virtualvisionlabs/bivouac-pat/dossier-29B/01-Impression-plastique.pdf

BIVOUAC / DOSSIER TECHNIQUE | RÉV. 29B · 08 OCT. 2026

# Maquette ergonomique en plastique

Spécification destinée au prestataire d’impression 3D • Échelle réelle 1:1

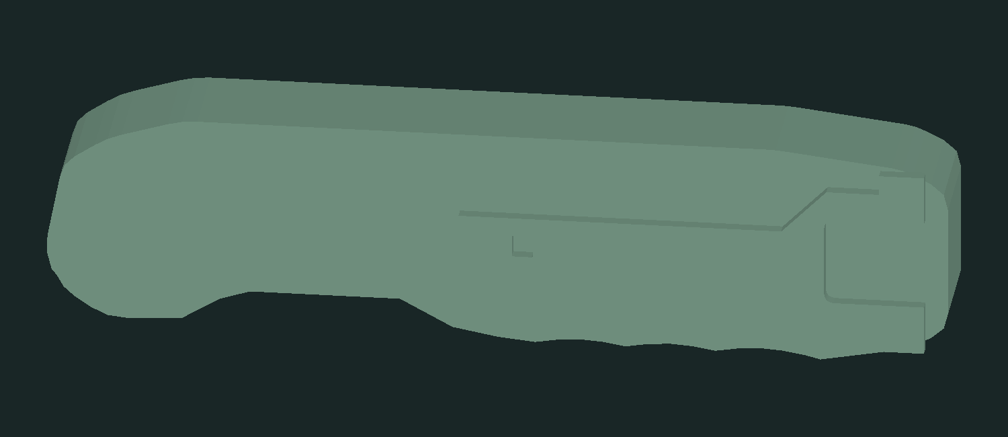
[picture p2: figure]

Aperçu du fichier imprimable : manche plein et volume de clip fixe. Monochrome.

## Objectifs de la maquette

Évaluer la longueur, l’épaisseur, les arrondis et les trois rainures du manche lors de la prise en main. Comparer le confort avec et sans le volume de la clip.

À commander | Dimensions nominales | Quantité proposée
01-Manche-plein-SANS-clip.stl | 120 × 30 × 14,4 mm | 1
02-Manche-plein-CLIP-FIXE.stl | 120 × 30 × 16,1 mm | 1

Deux variantes monoblocs indépendantes. Ces maquettes ne sont pas destinées à être assemblées entre elles. Le lot ne comprend ni lame, ni mécanisme, ni quincaillerie.

Priorité en cas de réalisation d’une seule variante : modèle CLIP-FIXE, destiné à évaluer l’encombrement complet dans la main.

BIV-29B-IMP · 29B · Assistance IA · Document non signé par un ingénieur | 1

# Instructions pour l’imprimeur

À joindre aux deux fichiers STL du dossier 01-Impression-plastique

Paramètre | Demande / point à confirmer
Unité et échelle | Importer en millimètres. Échelle 100 %. Ne pas ajuster à la taille du plateau.
Orientation | Grande face plane à Z=0 sur le plateau; clip vers le haut. Les fichiers sont déjà orientés ainsi.
Procédé proposé | FDM en PLA pour un essai de forme; PETG possible selon l’atelier. SLS PA12 possible, mais non nécessaire pour ce premier essai. [S6–S8]
Réglages de départ | Buse 0,4 mm, couche 0,20 mm, 3 périmètres, 5 couches haut/bas, remplissage 20 %. Proposition à adapter au profil machine.
Supports | Aucun support intérieur : les modèles sont pleins. Vérifier les surplombs dans le trancheur avant impression.
Finition | Ébavurer légèrement. Conserver les rainures et le contour. Ne pas poncer fortement les zones de prise avant la première évaluation.
Contrôle demandé | Mesurer longueur, largeur et épaisseur. Cible de réception proposée : ±0,3 mm sur les trois dimensions globales; à accepter par l’atelier.
Masse | La masse imprimée dépend du remplissage. Elle ne reproduit pas le poids ou l’équilibre du couteau métallique.

Le plastique imprimé sert seulement à la prise en main. Il n’est pas proposé ici pour manger, couper, gratter une pierre à feu ou tester la résistance d’une clip.

BIV-29B-IMP · 29B · Assistance IA · Document non signé par un ingénieur | 2

# Périmètre de la maquette

Caractéristiques reproduites et limites de représentativité

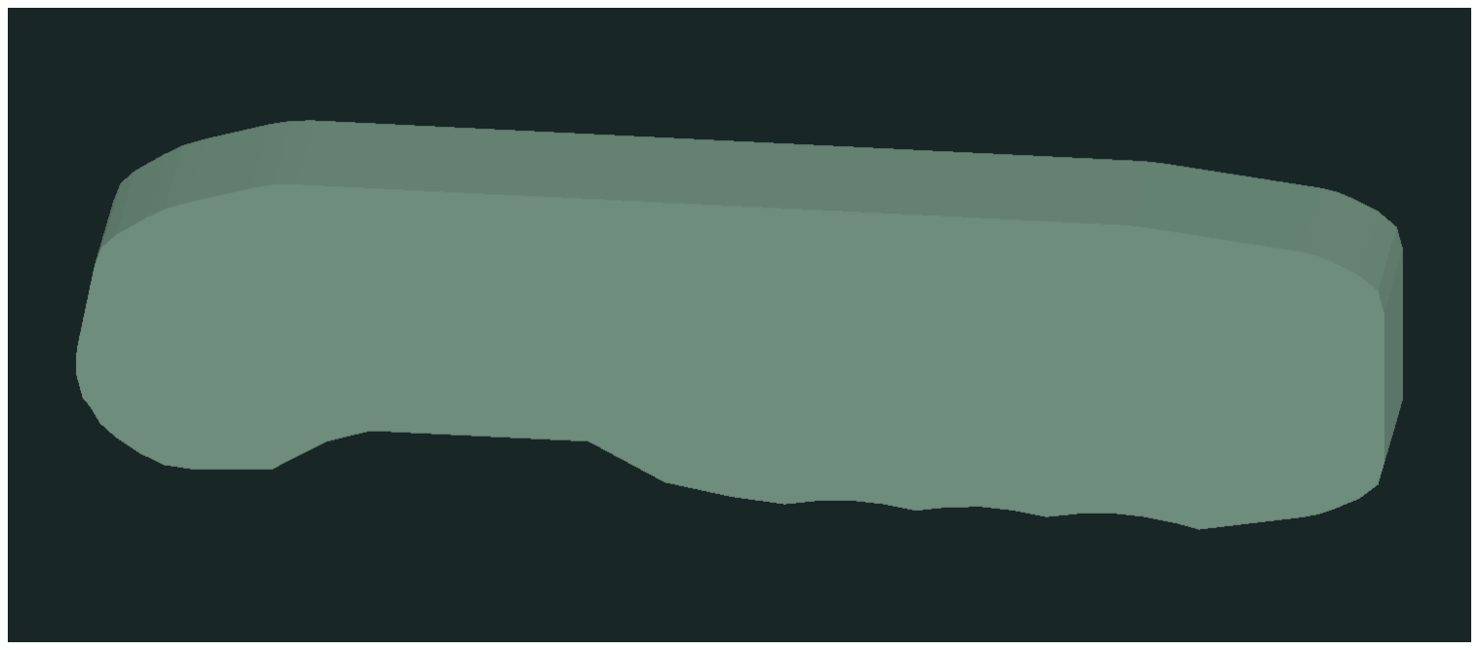
[picture p3: figure]

Reproduit | Simplifié / absent
Contour du manche v29, arrondis en vue de face, trois rainures basses. | Intérieur rempli : pas de canaux, ressorts, fourchette mobile ou allume-feu.
Longueur 120 mm; largeur maximale 30 mm; corps 14,4 mm. | Pas de texture G10 ni de finitions métalliques; aucune lame, même factice.
Empreinte et encombrement supérieur de la clip dans la deuxième version. | Clip solidaire du manche, vide sous la clip rempli, dessus ramené à une enveloppe plane. Pas de flexion ni d’essai de port en poche.
Épaisseur totale 16,1 mm avec le volume fixe de clip. | Gravures et détails de vis supprimés. L’adhérence du pouce et l’accès aux accessoires ne sont pas validés par cette maquette.

L’étui n’est pas inclus dans ce premier lot imprimable. Le dossier fabricant et les GLB le décrivent séparément. Un essai d’emboîtement avec pièces mobiles demandera une seconde maquette, avec jeux adaptés au procédé choisi.

BIV-29B-IMP · 29B · Assistance IA · Document non signé par un ingénieur | 3

# Fiche d’évaluation ergonomique

À remplir après réception • Aucun outil ni mise en charge nécessaire

Observation | Résultat / modification souhaitée
Date, matière et atelier | ____________________________________________
Dimensions mesurées L × l × e | ____________________________________________
Main dominante / gants | ____________________________________________
Longueur du manche | Trop court / correct / trop long
Épaisseur | Trop mince / correcte / trop épaisse
Rainures sous les doigts | Gênantes / neutres / utiles
Angle sous l’index et talon | ____________________________________________
Volume de clip dans la paume | Gênant / acceptable / confortable
Tenue pendant 30 à 60 secondes | Points de pression : __________________________
Version préférée et raison | ____________________________________________
Décision pour la suite | Garder les formes / corriger avant la maquette mobile

Noter les retouches souhaitées en millimètres si possible et photographier la main autour de la maquette. Évaluer d’abord la forme; ne pas conclure sur le poids, la retenue ou la solidité du futur couteau.

BIV-29B-IMP · 29B · Assistance IA · Document non signé par un ingénieur | 4

# Vérification des fichiers et commande

Fichiers maillés contrôlés numériquement • Impression physique non réalisée

Fichier | Résultat du contrôle
01-Manche-plein-SANS-clip.stl | 1 volume connecté fermé; normales cohérentes; 216 triangles; dimensions relues après export conformes à 0,002 mm près.
02-Manche-plein-CLIP-FIXE.stl | 1 volume connecté fermé; normales cohérentes; 792 triangles; dimensions relues après export conformes à 0,002 mm près.

## Objet de la consultation

Réalisation de deux maquettes ergonomiques de manche, à raison d’un exemplaire par variante, à l’échelle 100 % en millimètres. Matière proposée : PLA, finition simple. Le prestataire est invité à vérifier les fichiers dans son trancheur et à confirmer l’orientation, le coût et les dimensions obtenues. Aucune pièce métallique ni aucun mécanisme ne fait partie de ce lot.

## Références matière

S6 — Formlabs — Nylon 12 SLS, guide matière. Consulter le fabricant. (https://now.formlabs.com/resources/nylon-12-sls)

S7 — Prusa — guide des filaments. Consulter le fabricant. (https://help.prusa3d.com/filament-material-guide)

S8 — Prusa — PETG. Consulter le fabricant. (https://help.prusa3d.com/article/petg_2059)

Références consultées le 8 octobre 2026. Les réglages proposés sont un point de départ pour l’atelier, pas une qualification d’imprimante.

BIV-29B-IMP · 29B · Assistance IA · Document non signé par un ingénieur | 5
