virtualvisionlabs/bivouac-pat/dossier-29B/03-Patrons-echelle-1.pdf

# Manche fermé — patron à l’échelle 1:1

Imprimer à 100 % / taille réelle. Désactiver « Ajuster à la page ». Toutes les dimensions sont en mm.

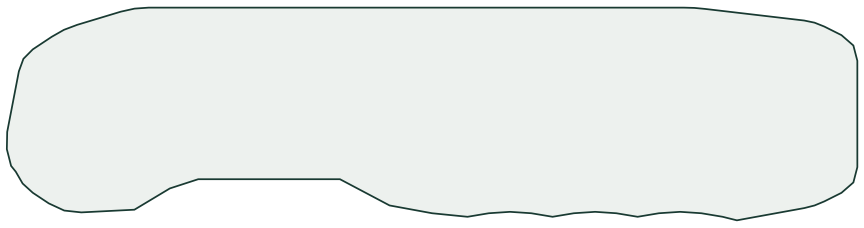
[picture p4: figure]

BIV-29B-GAB · 08/10/2026 · Contours de référence, pas des tracés de découpe de production · 1/2

### Contour 120 × 30 mm — corps de 14,4 mm hors clip

Épaisseur du manche sans clip : 14,4 mm (rectangle de contrôle).

Enveloppe avec clip : 16,1 mm. Ce rectangle ne représente pas sa cambrure.

Cette barre doit mesurer exactement 100 mm sur le papier.

# Étui et lame — contours de référence 1:1

Imprimer à 100 % / taille réelle. Désactiver « Ajuster à la page ». Toutes les dimensions sont en mm.

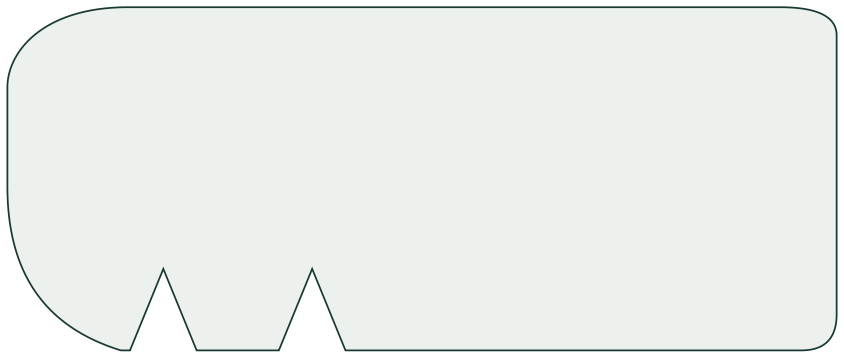
[picture p5: figure]

BIV-29B-GAB · 08/10/2026 · Contours de référence, pas des tracés de découpe de production · 2/2

Étui : profil 117 × 48,4 mm; épaisseur totale 24,75 mm avec clip.

Lame : contour total 100 × 22,893 mm, talon inclus. Pas de biseau ni de tolérance de fabrication.

Cette barre doit mesurer exactement 100 mm sur le papier.
