virtualvisionlabs/bivouac-pat/apercu.jpg

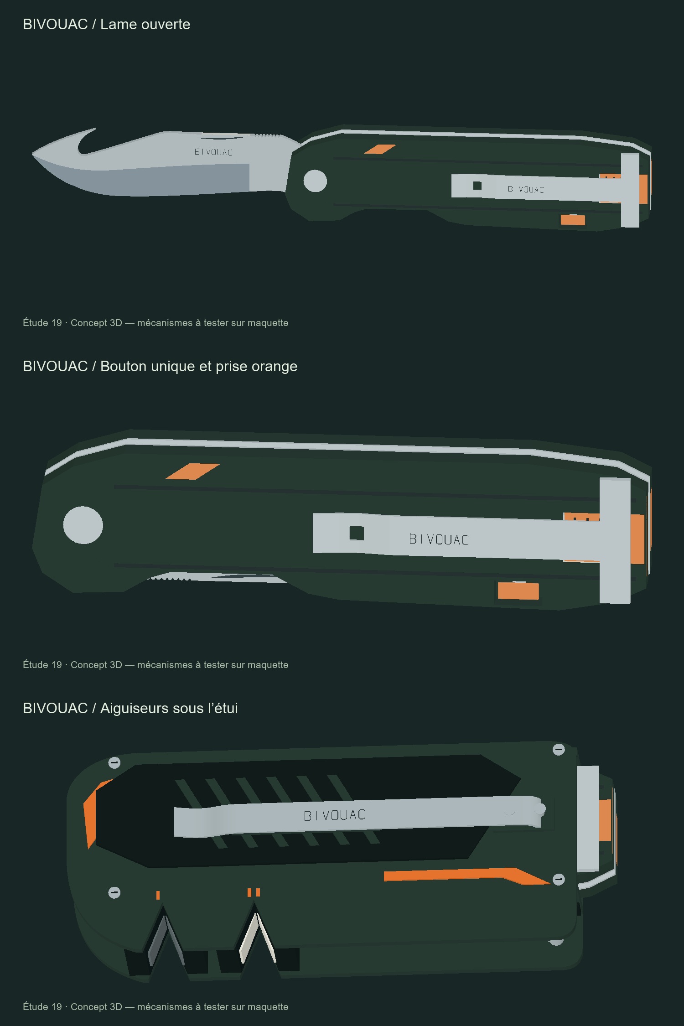
apercu.jpg
