virtualvisionlabs/bivouac-pat/BIVOUAC-verrou-explique.png

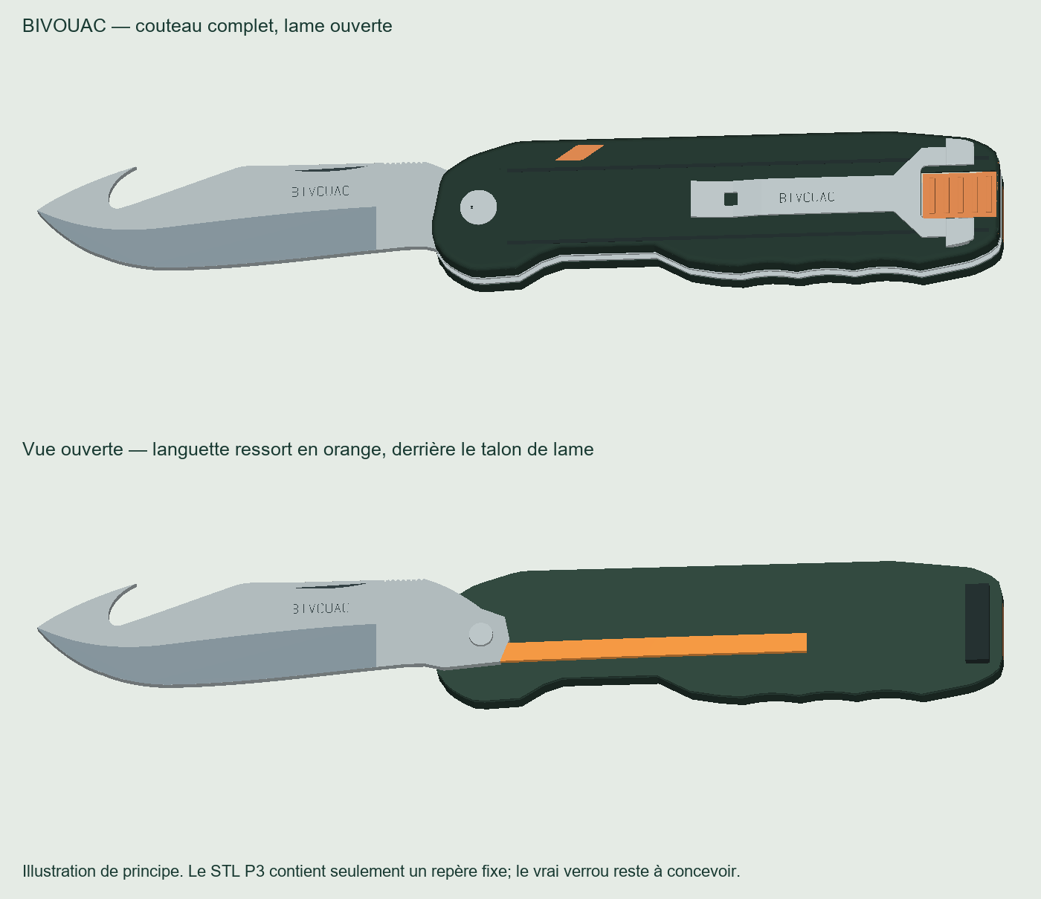
BIVOUAC-verrou-explique.png
