virtualvisionlabs/bivouac-pat/dossier-29B/couteau.png

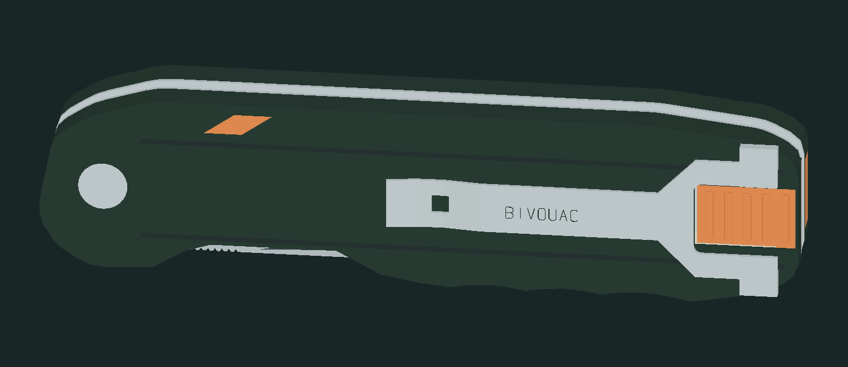
dossier-29B/couteau.png
