virtualvisionlabs/bivouac-pat/etui-e1/Apercu-etui-E1.png

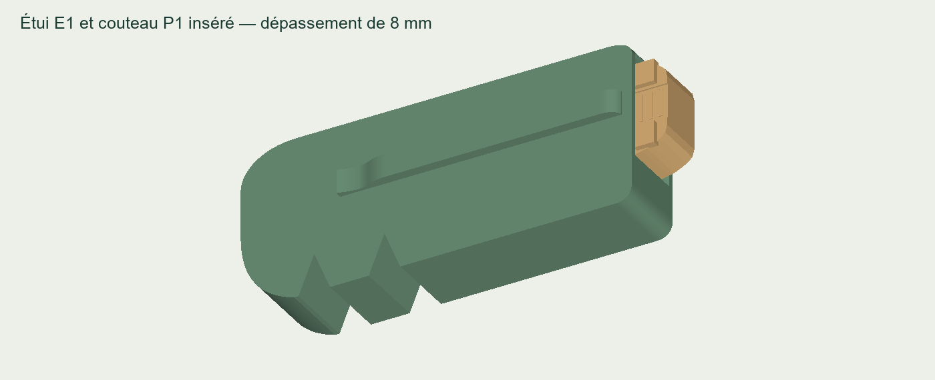
etui-e1/Apercu-etui-E1.png
