virtualvisionlabs/bivouac-pat/etui-e1/Coupe-explicative-E1.png

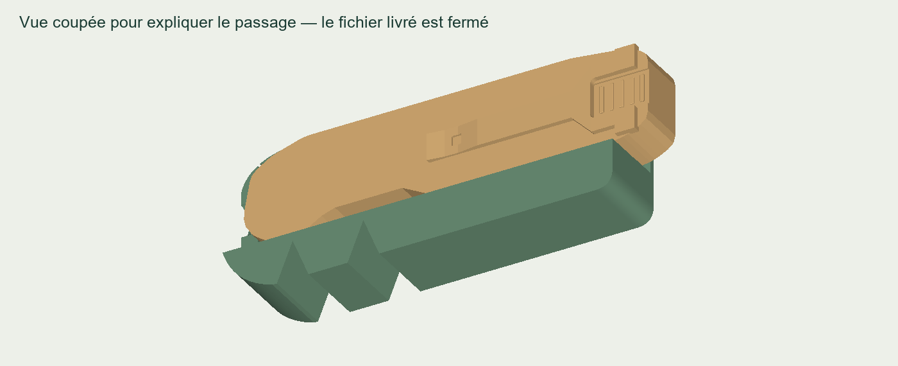
etui-e1/Coupe-explicative-E1.png
