virtualvisionlabs/bivouac-pat/film-affiche.jpg

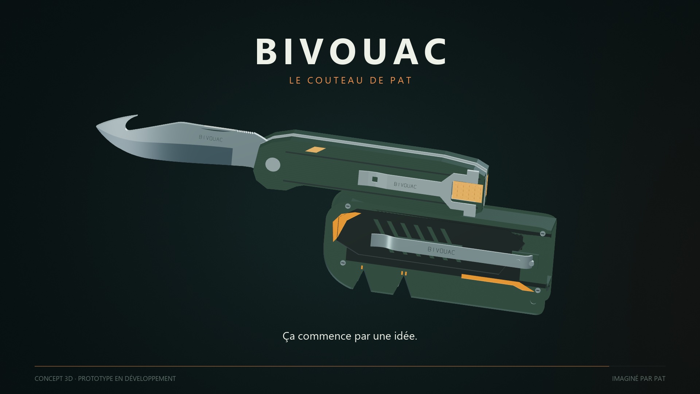
film-affiche.jpg
