virtualvisionlabs/bivouac-pat/maquette-p1/Apercu-maquette-P1.png

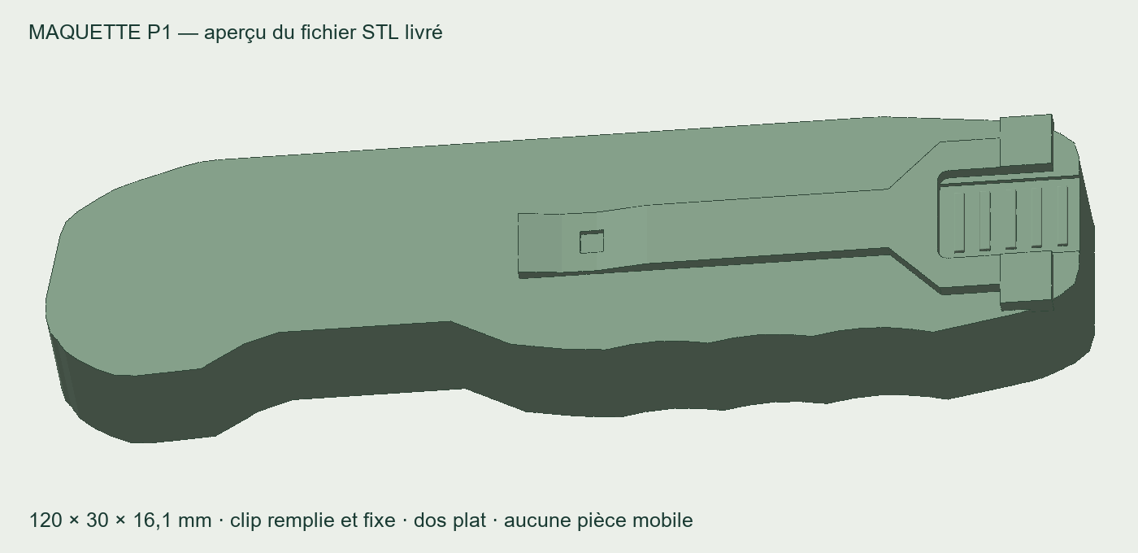
maquette-p1/Apercu-maquette-P1.png
