virtualvisionlabs/bivouac-pat/maquette-p2/Apercu-maquette-P2.png

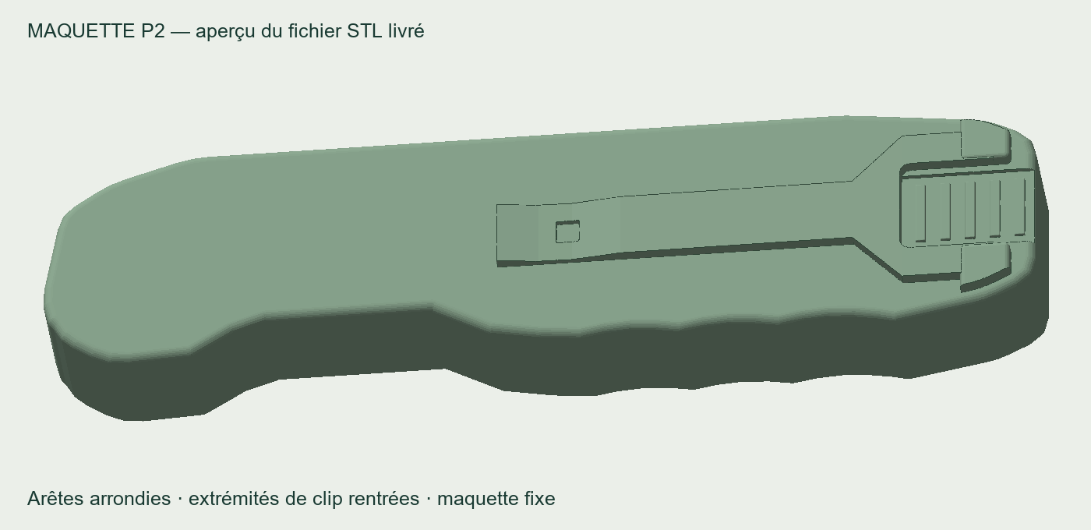
maquette-p2/Apercu-maquette-P2.png
