virtualvisionlabs/bivouac-pat/p3-e2/Couteau-P3.png

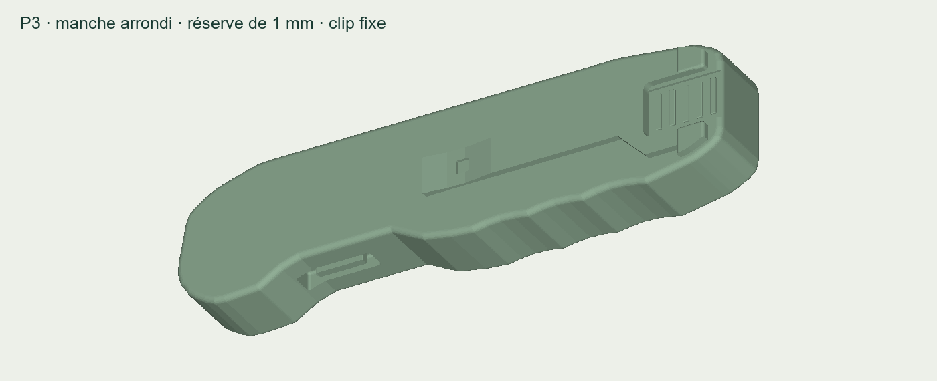
p3-e2/Couteau-P3.png
