virtualvisionlabs/bivouac-pat/p3-e2/Dos-P3.png

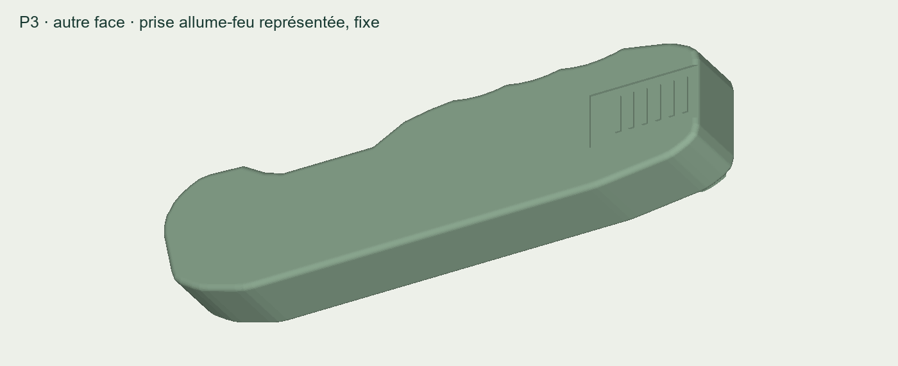
p3-e2/Dos-P3.png
