virtualvisionlabs/bivouac-pat/etui-e1/02-Gabarit-ajustement-OPTIONNEL-mm.3mf

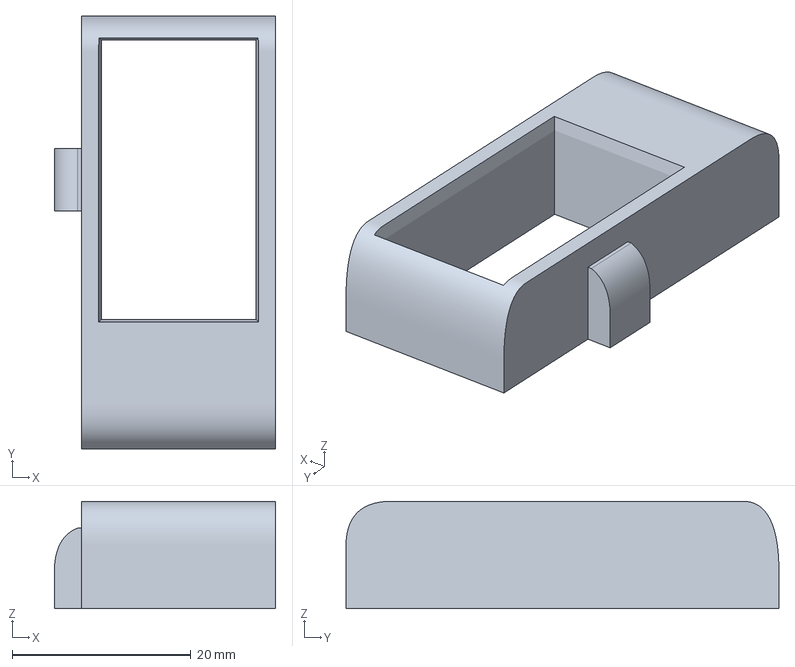
[picture p16: CAD file, 2026-10-10]
etui-e1/02-Gabarit-ajustement-OPTIONNEL-mm.3mf
24.8 x 48.4 x 12.0 mm
