virtualvisionlabs/bivouac-pat/maquette-p1/BIVOUAC-Maquette-fermee-P1-mm.3mf

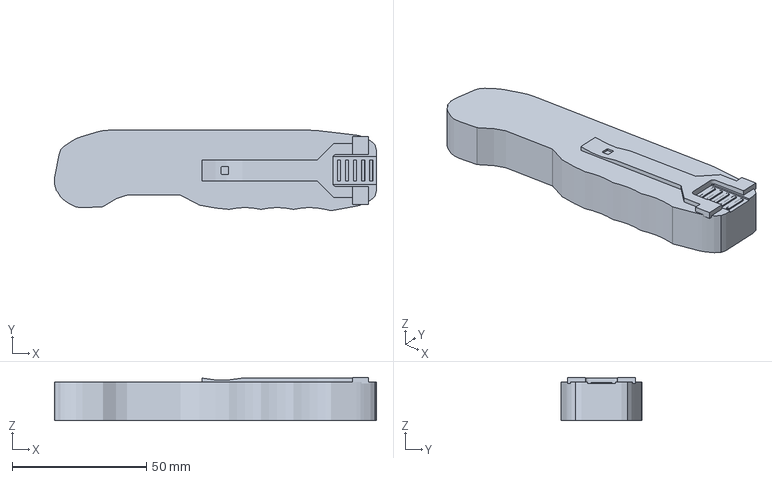
[picture p17: CAD file, 2026-10-09]
maquette-p1/BIVOUAC-Maquette-fermee-P1-mm.3mf
120.0 x 30.0 x 16.1 mm
