virtualvisionlabs/bivouac-pat/maquette-p2/BIVOUAC-Maquette-fermee-P2-mm.3mf

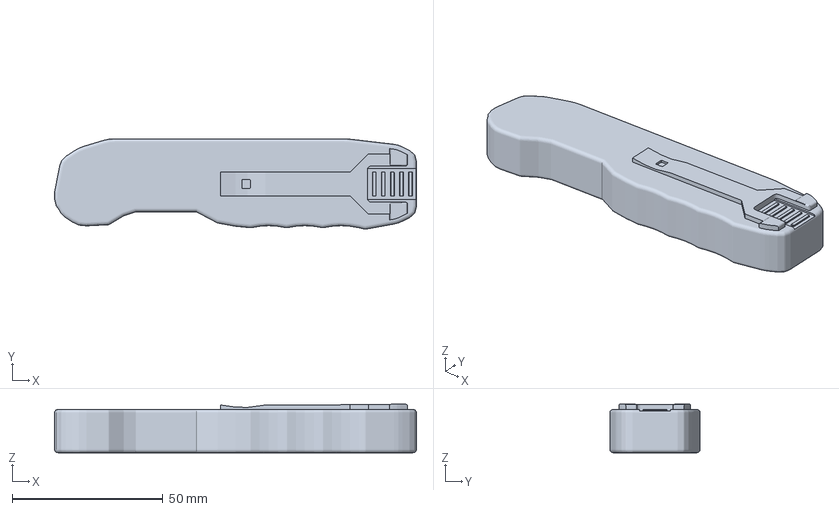
[picture p18: CAD file, 2026-10-11]
maquette-p2/BIVOUAC-Maquette-fermee-P2-mm.3mf
120.0 x 30.0 x 16.1 mm
