virtualvisionlabs/bivouac-pat/p3-e2/BIVOUAC-Maquette-fermee-P3-mm.3mf

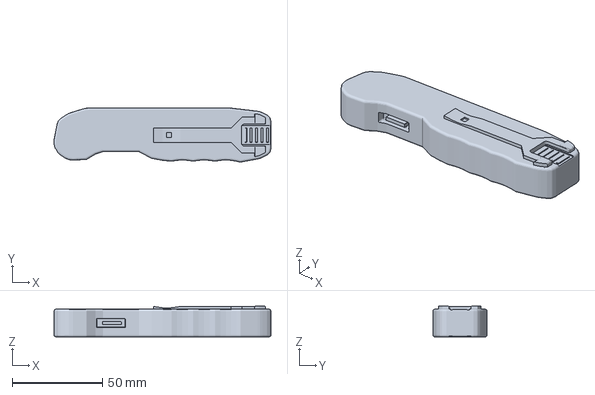
[picture p19: CAD file, 2026-10-11]
p3-e2/BIVOUAC-Maquette-fermee-P3-mm.3mf
120.0 x 30.0 x 17.1 mm
