virtualvisionlabs/bivouac-pat/etui-e1/01-Etui-E1-pour-couteau-P1-mm.3mf

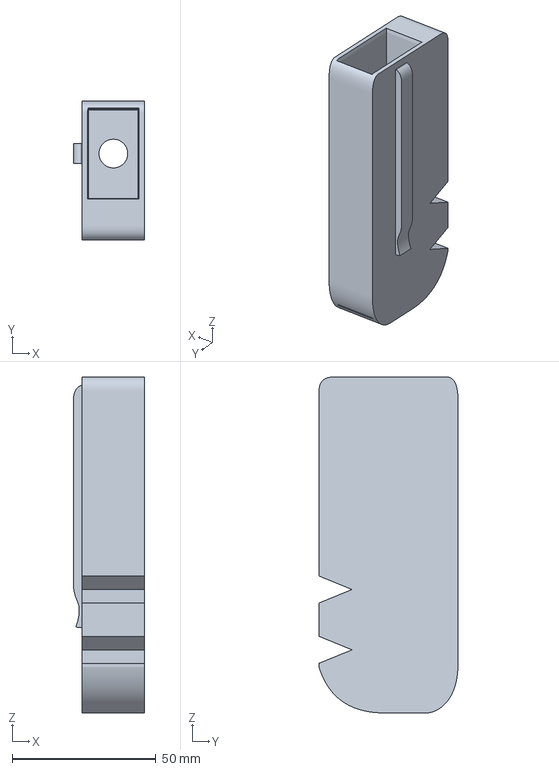
[picture p20: CAD file, 2026-10-10]
etui-e1/01-Etui-E1-pour-couteau-P1-mm.3mf
24.8 x 48.4 x 117.0 mm
