virtualvisionlabs/bivouac-pat/p3-e2/Gabarit-E2-OPTIONNEL-mm.3mf

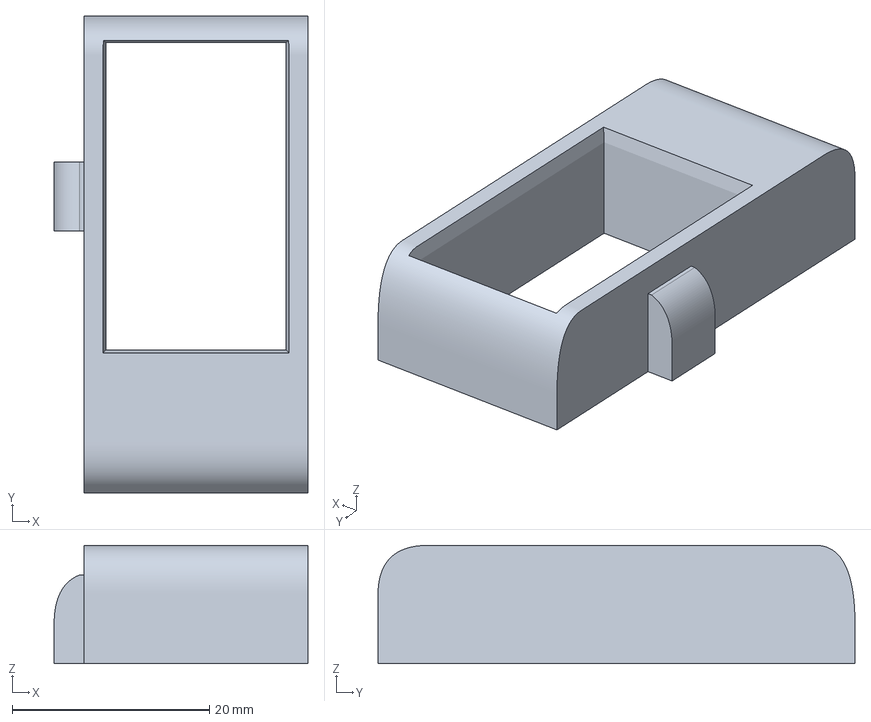
[picture p21: CAD file, 2026-10-11]
p3-e2/Gabarit-E2-OPTIONNEL-mm.3mf
25.8 x 48.4 x 12.0 mm
