virtualvisionlabs/bivouac-pat/prototype-plastique/02-Etui-complet-E2-pour-P3-mm.stl

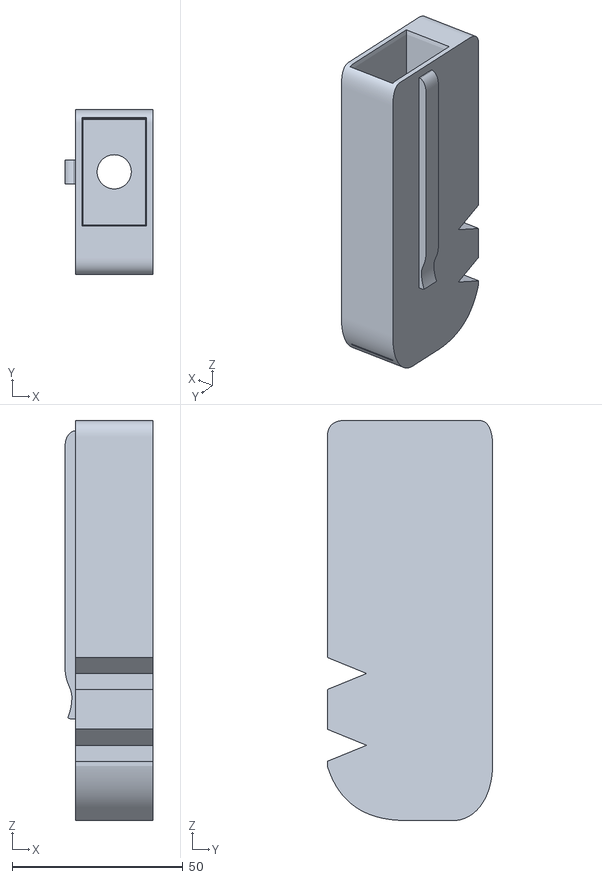
[picture p22: CAD file, 2026-10-11]
prototype-plastique/02-Etui-complet-E2-pour-P3-mm.stl
25.8 x 48.4 x 117.0
