virtualvisionlabs/bivouac-pat/(list of files, cad)

Other CAD files:
prototype-plastique/01-Couteau-complet-P3-mm.stl
p3-e2/Etui-E2-pour-P3-mm.3mf
etui-e1/01-Etui-E1-pour-couteau-P1-mm.stl
etui-e1/02-Gabarit-ajustement-OPTIONNEL-mm.stl
maquette-p1/BIVOUAC-Maquette-fermee-P1-mm.stl
maquette-p2/BIVOUAC-Maquette-fermee-P2-mm.stl
p3-e2/Gabarit-E2-OPTIONNEL-mm.stl
