virtualvisionlabs/bivouac-pat/maquette-p2/Instructions-imprimeuse-P2.pdf

## BIVOUAC / MAQUETTE PLASTIQUE P2

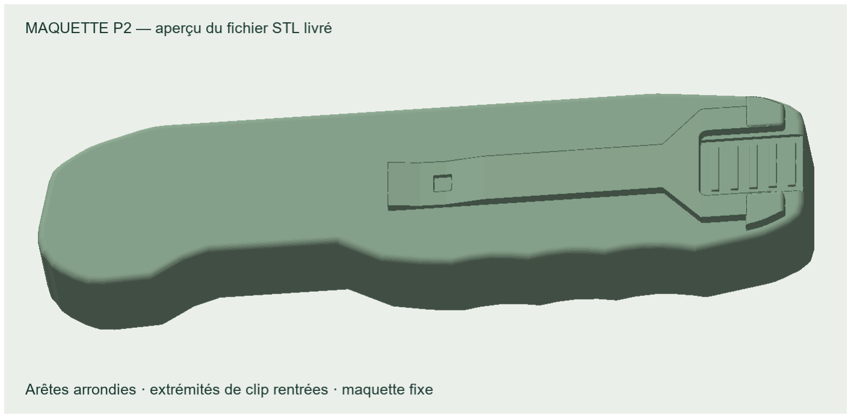
[picture p23: figure]

Objet : une maquette fermée inerte en PLA, d’un seul bloc, pour évaluer la prise en main. Révision P2 issue du retour sur l’impression P1. Aucun mécanisme mobile ni fonction coupante.

Modifications : arêtes périphériques du manche arrondies (rayon nominal 1,2 mm); deux extrémités de clip adoucies (rayon nominal 0,6 mm) et limitées à un contour situé 1,6 mm à l’intérieur du manche. Hauteur de clip conservée. Dos central plat; relief du côté allume-feu non ajouté dans cette révision.

Fichiers : BIVOUAC-Maquette-fermee-P2-mm.3mf ou .stl, deux formats du même objet. En choisir un seul. Unités : millimètres; échelle 100 %. Encombrement mesuré : 120,00 × 29,97 × 16,10 mm (valeurs arrondies).

Orientation et réglages proposés : dos plat sur le plateau, relief de clip vers le haut (orientation fournie). Buse 0,4 mm; couche 0,16 mm, première 0,20 mm; 4 périmètres; 6 couches pleines dessus/dessous; 30 % gyroid. Contrôler les supports et adapter températures/adhérence au profil de l’atelier.

Vérifications numériques : un solide fermé, 7,368 triangles, normales cohérentes, aucune face dégénérée. Import STL/3MF et tranchage réussis. Estimation générique : 28.48 g, supports compris, et 3h 2m 43s; l’atelier confirme avec sa machine.

Étui E1 : absence de collision vérifiée sur 455 positions d’insertion/retrait, dont des décalages de ±0,5 mm. Le jeu et le confort restent à vérifier sur les pièces imprimées. Ébavurer, mesurer et essayer la première pièce. Aucun essai physique P2 effectué; aucun G-code machine fourni.

P2 · 11 octobre 2026 · Maquette ergonomique uniquement · Pas de pièces à assembler
