virtualvisionlabs/bivouac-pat/etui-e1/Instructions-imprimeuse-E1.pdf

## ÉTUI E1 / IMPRESSION POUR MAQUETTE P1

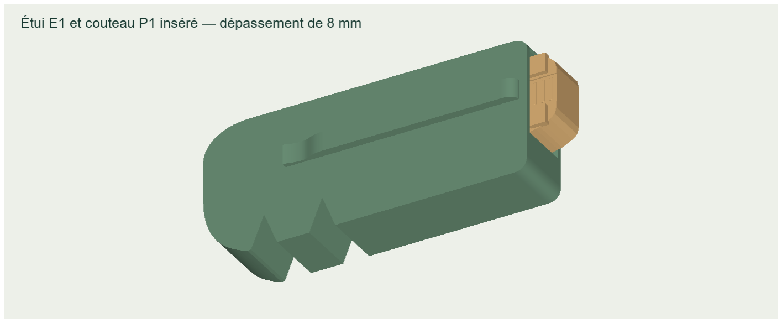
[picture p24: figure]

Prestation : imprimer un étui creux en PLA pour recevoir le couteau fermé P1 de 120 × 30 × 16,1 mm. Ce paquet ne contient pas le couteau. Sans verrou : il peut glisser hors de l’étui. Relief de clip fixe; affûteurs et tige non fonctionnels.

Dimensions : étui 117 × 48,4 × 24,75 mm; passage 31,2 × 17,3 mm, soit 0,6 mm de jeu nominal de chaque côté. Enfoncement 112 mm; talon accessible sur 8 mm. Trou avant Ø 10 mm. Fond et toit principaux de 2,2 mm; entrée légèrement évasée.

Fichier principal 01 : choisir le 3MF ou le STL, pas les deux. Millimètres, échelle 100 %. Il est orienté nez au plateau, ouverture vers le haut; hauteur d’impression 117 mm. Ce positionnement maintient le canal vertical.

Gabarit facultatif 02 : petite section traversante de 12 mm à tester avec le P1 déjà imprimé. Vérifier que le couteau, clip comprise, coulisse sans forcer. Essai conseillé avant l’étui complet. Si serré, revoir le jeu; ne pas agrandir tout l’étui automatiquement. Le gabarit contrôle le passage, pas les frottements sur toute la longueur.

Réglages proposés : PLA, buse 0,4 mm, couche 0,20 mm, 4 périmètres, 5 couches pleines haut/bas, gyroid 25 %. Bordure de 8 mm (4 mm pour le gabarit). Supports depuis le plateau sous les débords extérieurs. Garder le canal dégagé; inspecter toutes les couches avec le profil réel de l’atelier. Températures selon le filament.

Vérifications : chaque fichier est un solide fermé unique. Passage du P1 contrôlé sans intersection à 251 positions nominales et 204 positions décalées. Imports STL/3MF et tranchages réussis dans PrusaSlicer 2.9.2. Ajustement physique encore à confirmer sur les impressions réelles.

Estimations d’essai générique : étui ≈ 56 g / 5 h 01; gabarit ≈ 6 g / 33 min, bordures et supports compris. L’atelier confirme ses durées et son prix. Retirer les supports, ébavurer l’entrée et le passage avant essai. Aucun G-code machine fourni.

E1 · 9 octobre 2026 · Étui de maquette uniquement · Compatibilité numérique : couteau P1
