virtualvisionlabs/bivouac-pat/maquette-p1/Instructions-imprimeuse-P1.pdf

## BIVOUAC / MAQUETTE PLASTIQUE P1

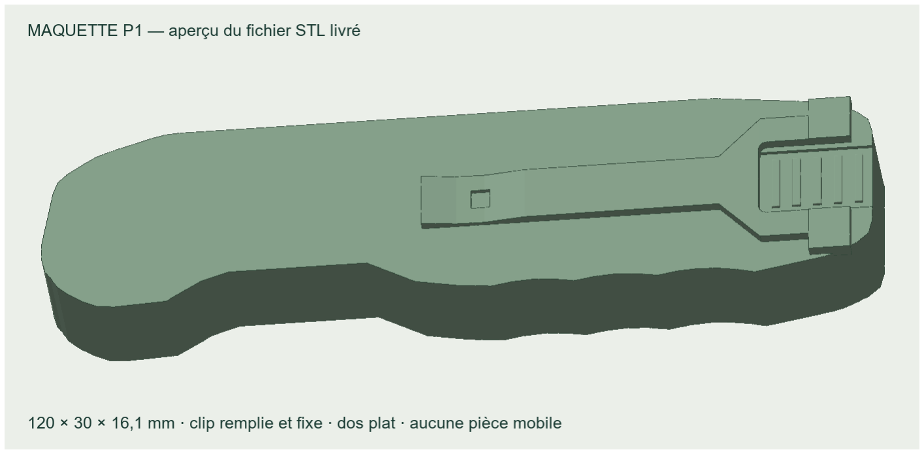
[picture p25: figure]

Objet de la prestation : imprimer une copie en PLA du couteau fermé, à taille réelle, pour évaluer forme, encombrement et prise en main. Maquette inerte d’un seul bloc; aucun mécanisme ni usage coupant.

Fichier : BIVOUAC-Maquette-fermee-P1-mm.3mf (unités incluses) ou .stl (importer en millimètres). Les deux formats représentent le même objet : en choisir un seul. Échelle 100 %. Dimensions : 120 × 30 × 16,1 mm.

Orientation : face arrière plane sur le plateau, relief de clip vers le haut. Le fichier est déjà orienté avec le dessous à Z = 0. La clip est remplie et fixe; le dos est aplani. Rainures de contour, galbe supérieur de clip, dépression de pouce et cinq nervures avant conservés. Textures, couleurs et microgravures de la démo ne sont pas reproduites.

Préparation proposée : buse 0,4 mm; couches 0,16 mm (première 0,20); 4 périmètres; 6 couches pleines en haut et en bas; remplissage gyroid 30 %. Activer et contrôler les supports, notamment sous les extrémités latérales de la clip. Températures et adhérence selon le PLA et le profil éprouvé de l’atelier.

Contrôles effectués : un seul solide fermé, normales cohérentes, 3 454 triangles. Import et tranchage réussis dans PrusaSlicer 2.9.2. Essai générique : environ 29 g de filament, supports compris, et environ 3 h 07. Ce ne sont pas un devis ni une garantie pour une autre machine.

À réaliser par l’atelier : utiliser le profil de son imprimante, vérifier les supports et l’aperçu des couches, retirer les supports, ébavurer puis contrôler les dimensions. Aucune réparation d’enveloppes multiples n’est demandée. Aucun essai physique réalisé à ce jour. Le G-code d’essai n’est pas livré; il ne correspond pas à la machine de l’atelier.

P1 · 9 octobre 2026 · Maquette ergonomique uniquement · Pas de pièces à assembler
