virtualvisionlabs/bivouac-pat/verification-stl-v28/Verification-STL-complet-v28.pdf

BIVOUAC / CONTRÔLE DE MAQUETTE | V28 · RAPPORT A

# Résultat de la vérification

Dimensions cohérentes. Préparation du maillage à terminer avant impression. Le fichier reçu ne peut pas être confirmé comme un unique solide fusionné prêt à imprimer. Cette réserve concerne la préparation du STL, pas le choix esthétique du produit.

Objet examiné : couteau fermé v28, maquette inerte destinée à la prise en main. Aucune pièce mobile, aucune utilisation coupante. Le fichier reçu est conservé sans modification; aucun nouveau STL n’est produit, conformément à la demande jointe.

Contrôle | Constat
Dimensions du STL | 120,029 × 30,140 × 16,100 mm
GLB v28 de référence | 120,000 × 30,000 × 16,100 mm
Écart d’enveloppe | +0,029 mm en longueur; +0,140 mm en hauteur; épaisseur identique à l’arrondi.
Triangles / coordonnées | 232 112 triangles; aucune coordonnée non finie.
Fermeture / orientation | Test « watertight » positif; orientations cohérentes après soudage des sommets identiques.
Continuité du maillage | 318 composantes surfaciques; 43 ont un volume nul à 10⁹ mm³ près.

Ce que signifie le résultat

Un STL peut réunir plusieurs enveloppes fermées sans que leurs volumes soient fusionnés. Le résultat « étanche » ne démontre donc ni un seul bloc propre, ni l’absence de surfaces internes, de chevauchements ou de détails flottants.

Un diagnostic complémentaire d’union des 275 composantes de volume non nul conserve 236 composantes. Ce calcul n’a pas été exporté comme modèle réparé. Certaines composantes peuvent être internes ou emboîtées : ces nombres ne signifient pas qu’autant de pièces tomberaient de l’imprimante.

Conclusion : demander une préparation en solide unique adapté à la maquette, puis un contrôle couche par couche dans le trancheur. Un trancheur peut résoudre certains chevauchements; ce comportement n’a pas été vérifié ici.

BIV-STL-28 / A · 9 octobre 2026 · Vérification numérique, sans essai physique | 1

# Impression FDM : points sensibles

Le fichier contient 119 composantes dont au moins une dimension de boîte englobante est inférieure à 0,1 mm, avec notamment des éléments de 0,003 mm. Il s’agit d’un indicateur de détails fins, et non d’une mesure exhaustive d’épaisseur de paroi. Ces éléments ne doivent pas être considérés comme des détails FDM garantis avec une buse de 0,4 mm.

Orientation proposée à l’atelier

À plat sur le grand côté opposé à la clip, clip vers le haut. Dans le repère reçu : Z positif vers le haut; translater la pièce d’environ +7,2 mm en Z pour amener le point le plus bas au plateau. Cette orientation limite la hauteur à environ 16,1 mm et préserve mieux le côté de la clip.

Le contact initial n’est pas une grande face plane garantie. Vérifier la première couche et prévoir les supports locaux nécessaires sous les reliefs du côté posé au plateau. Les zones en porte-à-faux sous la clip et ses épaules doivent être contrôlées séparément; éviter de supposer qu’elles se pontent correctement ou que les supports seront faciles à retirer.

La clip est une forme de maquette : ne pas la plier ni tester son élasticité comme une clip métallique. Ses zones fines risquent de casser au retrait des supports. Prévoir une prise en main sans mise en charge de la clip.

Coupes du fichier effectivement reçu

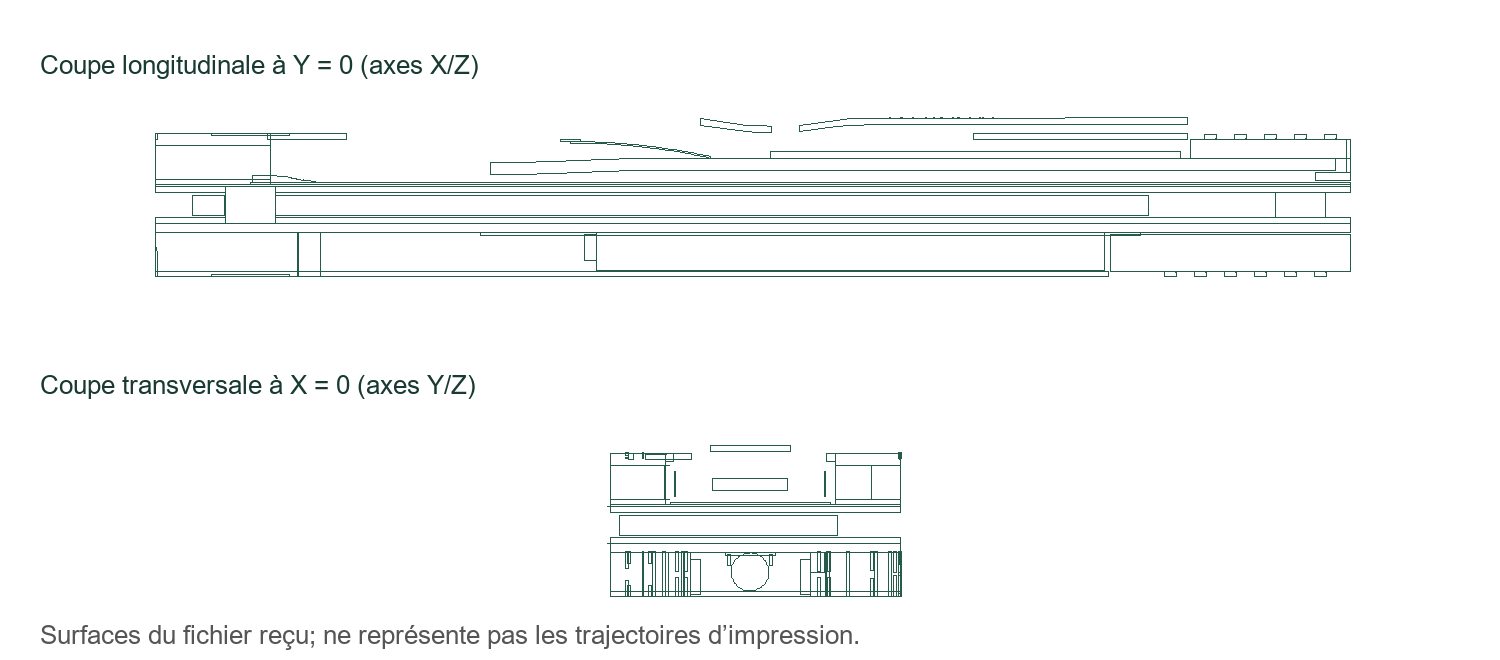
[picture p36: figure]

Les lignes représentent les surfaces traversées par les plans de coupe. Elles montrent des interfaces internes; ce ne sont ni des couches de matière ni une simulation du trancheur.

BIV-STL-28 / A · 9 octobre 2026 · Vérification numérique, sans essai physique | 2

# Réglages et évaluation du poids

Les valeurs suivantes sont des points de départ proposés pour une maquette PLA, à adapter par l’atelier après préparation géométrique et selon son matériel. Aucun profil machine ni G-code n’est fourni.

Paramètre | Proposition
Échelle | 100 %, dimensions en millimètres. Le format STL ne fixe pas lui-même l’unité.
Buse / couches | Buse 0,4 mm; couches 0,16 à 0,20 mm.
Parois / dessus-dessous | 4 périmètres; environ 0,8 à 1,0 mm de couches pleines en haut et en bas.
Remplissage initial | 30 % gyroid pour un premier essai de forme et de prise en main.
Supports | À décider dans l’aperçu tranché, en particulier sous la clip et les reliefs.
Températures / adhérence | Profil PLA éprouvé de l’atelier; ajuster l’adhérence après inspection de la première couche.

Un pourcentage ne garantit pas un poids réaliste

La masse finale du couteau métallique n’est pas définie. Aucun taux de remplissage ne peut donc reproduire son poids avec certitude. Le trancheur doit annoncer la masse estimée de la pièce, puis une balance doit confirmer la masse imprimée.

À titre de borne supérieure, toute la boîte de 120,029 × 30,140 × 16,100 mm remplie de PLA à 1,24 g/cm³ pèserait environ 72,2 g. Le couteau réel en plastique occupe moins que cette boîte. Ce chiffre n’est pas une prédiction de masse, et exclut supports et bordure [S4].

Le volume brut affiché par une lecture du STL additionne des enveloppes : il peut compter plusieurs fois des zones superposées. Il ne faut pas le convertir directement en poids. Si une masse cible supérieure est souhaitée plus tard, une maquette lestée demanderait une adaptation distincte et une répartition du lest réfléchie.

Le remplissage affecte la consommation et la masse; le nombre de périmètres est aussi déterminant pour la résistance. Les recommandations générales de Prusa appuient ce choix de réglages, sans valider cette géométrie particulière [S1–S3].

BIV-STL-28 / A · 9 octobre 2026 · Vérification numérique, sans essai physique | 3

# Transmission et traçabilité

Travail demandé avant lancement de l’impression

1. Conserver une copie du STL reçu et le design extérieur v28. Préparer une maquette inerte réellement unifiée, en supprimant les enveloppes sans volume et en traitant les surfaces internes ainsi que les détails sous-résolution. Ne pas laisser la réparation automatique décider seule des petits jeux à fermer.
2. Vérifier les dimensions et le maintien des rainures, arrondis et volumes de clip après cette préparation. Toute simplification extérieure doit être signalée au responsable du projet.
3. Trancher avec le profil de la machine prévue. Inspecter toutes les couches : première couche, îlots, continuité, clip, supports et accès pour leur retrait. Confirmer consommation et masse estimée avant impression.
4. Imprimer une seule maquette de contrôle, mesurer longueur/hauteur/épaisseur et masse, puis vérifier la prise en main. Aucun essai de fonctionnement mécanique n’est attendu.

Périmètre des preuves

Contrôles réalisés : lecture du STL, soudage de sommets coïncidents, dimensions, fermeture topologique, orientations, composantes, diagnostic d’union volumique et comparaison des enveloppes avec le GLB v28 d’origine. Aucun essai dans un trancheur ni essai physique. Aucun contrôle exhaustif de collision ou d’auto-intersection. La comparaison dimensionnelle ne prouve pas une identité de toutes les surfaces.

Original : maquette-couteau-ferme.stl, 11 605 684 octets.
SHA-256 : 78276c1cbbce0d2c5abafcff81768305
3c08fe72a553bbf7fae97793bb632316
L’archive de retour conserve les mêmes octets sous un nom mentionnant ORIGINAL-NON-VALIDE.
Références techniques consultées le 9 octobre 2026

[S1] Prusa — Layers and perimeters (https://help.prusa3d.com/article/layers-and-perimeters_1748)

[S2] Prusa — Support material (https://help.prusa3d.com/article/support-material_1698)

[S3] Prusa — Infill (https://help.prusa3d.com/article/infill_42)

[S4] Prusament PLA — fiche technique, densité 1,24 g/cm³ (https://prusament.com/wp-content/uploads/2022/10/PLA_Prusament_TDS_2021_10_EN.pdf)

[S5] Prusa — Split to objects/parts : enveloppes dans un fichier (https://help.prusa3d.com/article/split-to-objects-parts_1751)

BIV-STL-28 / A · 9 octobre 2026 · Vérification numérique, sans essai physique | 4
