virtualvisionlabs/bivouac-pat/(commit log)

2026-10-07 Publier la presentation BIVOUAC de Pat version 19
2026-10-07 Ajouter inspection au ralenti et gros plan de la retenue de fourchette
2026-10-07 Degager la vue du bouton avec le repere 1 sous le couteau
2026-10-07 Retirer les reperes superposes au couteau
2026-10-07 Publier la manipulation au doigt du couteau de Pat
2026-10-07 Publish study 22 with passive detents and camera pan
2026-10-08 Publish printable grip mockups and Pat manufacturer dossier 29A
2026-10-09 Publish corrected P1 plastic mockup package for printing
    [BIVOUAC-Maquette-fermee-P1-mm.3mf, BIVOUAC-Maquette-fermee-P1-mm.stl]
2026-10-10 Publish E1 sheath print package and instructions
    [01-Etui-E1-pour-couteau-P1-mm.3mf, 01-Etui-E1-pour-couteau-P1-mm.stl, 02-Gabarit-ajustement-OPTIONNEL-mm.3mf, 02-Gabarit-ajustement-OPTIONNEL-mm.stl]
2026-10-11 Publish P2 rounded ergonomic print mockup
2026-10-11 Add touch-controlled 3D viewer for exact P2 print mesh
2026-10-11 Publish P3 print mockup, E2 sheath and mobile 3D preview
2026-10-11 Show lock through assembled handle and animate closing and reopening
2026-10-11 Deliver simple two-STL plastic prototype package
